dpiegdon/kicad-modules/package3d/LED_5730.step

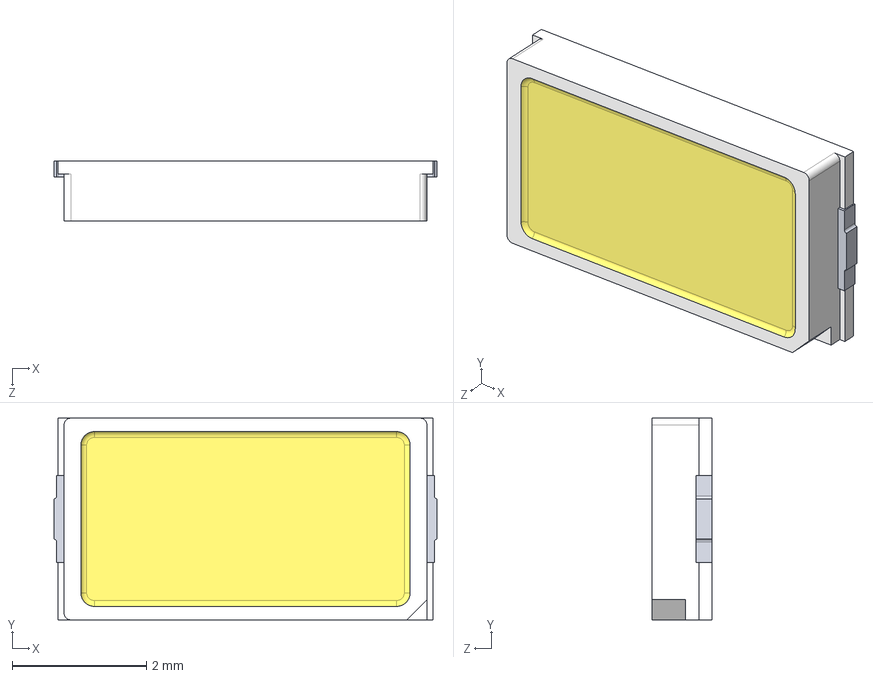
[picture p1: CAD file, 2025-06-07]
package3d/LED_5730.step
5.70 x 3.00 x 0.9 mm
