dpiegdon/kicad-modules/package3d/TS-1224W_Side_Button_2x4x3.3mm_3.5mm_3.8mm_SMD_Aliexpress.step

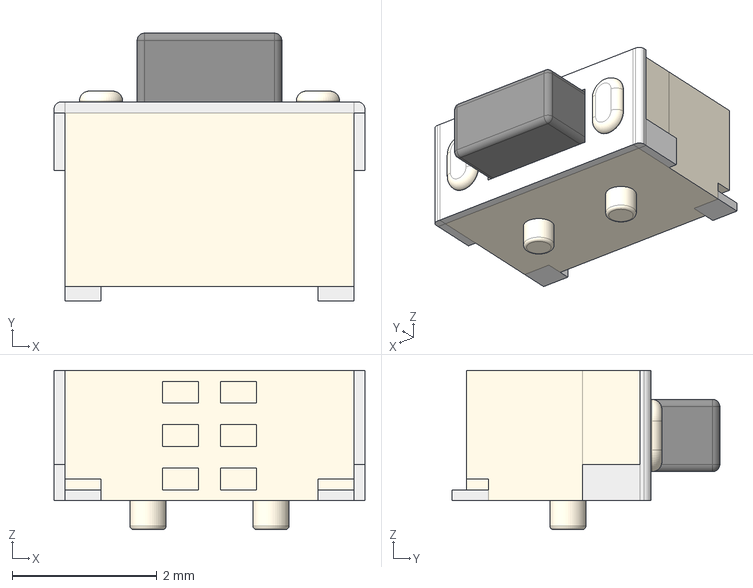
[picture p2: CAD file, 2019-12-23]
package3d/TS-1224W_Side_Button_2x4x3.3mm_3.5mm_3.8mm_SMD_Aliexpress.step
4.30 x 3.70 x 2.20 mm
