dpiegdon/kicad-modules/package3d/BatteryHolder_CR2450_BC-2005.step

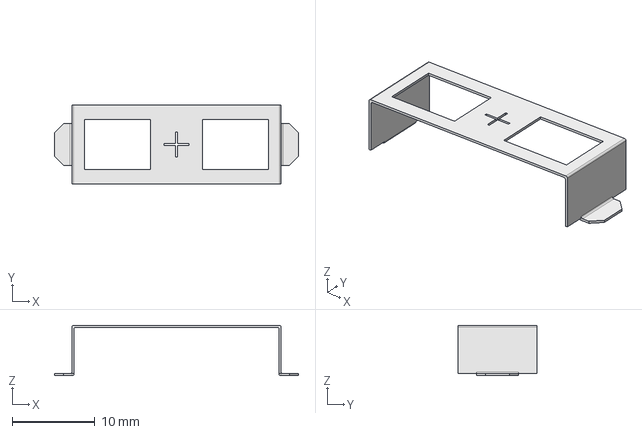
[picture p3: CAD file, 2019-12-22]
package3d/BatteryHolder_CR2450_BC-2005.step
29.5 x 9.56 x 6.09 mm
