dpiegdon/kicad-modules/(list of files, cad)

Other CAD files:
package3d/BatteryHolder_CR2450_BC-2005.FCStd
package3d/TS-1224W_Side_Button_2x4x3.3mm_3.5mm_3.8mm_SMD_Aliexpress.FCStd
