dpiegdon/kicad-modules/(commit log)

2015-08-16 on_semi n/p mosfet
2015-08-24 current, cleanup
2015-08-26 custom footprint lib
2015-08-27 solder masks, cleanup
2015-08-27 current footprints
2015-08-28 some more footprints
2015-09-02 removed unused, empty SIM footprints
2015-09-11 added IRF7509PBF-1 piece and Micro8 footprint
2015-09-14 corrected pin order for MFF2 footprint
2015-09-14 added missing GND pins to LSM303D and AT24CM02
2015-09-16 fixed DHVQFN20 (was mirrored) ; GE866 footprint cleanup for nicer schematic
2015-09-16 cleanup GSM antenna 2JE03
2015-09-16 GSM and GPS antenna cleanup
2015-09-20 cleanup STM32L051 footprint stuff
2015-09-20 SIM card slot footprint
2015-09-21 STM32L0xxKx cleanup: generalisations, footprint cleanup
2015-09-21 removed obsolete UFQFPN32 (replaced by standard QFN-32-1EP_5x5mm_Pitch0.5mm)
2015-09-21 STM32L0xxKx: difference between QFN32 and QFP32...: 2 less usable pins...
2015-09-21 removed obsolete QFN32_5x5 (use Housings_DFN_QFN:QFN-32-1EP_5x5mm_Pitch0.5mm)
2015-09-22 cleanup of all SIM footprints
2015-09-23 STM32L0*: mark VSS pin as power output
2016-03-31 fixed LTC3331 pin type to avoid DRC error when pulling balancer to GND
2016-04-10 added fiducial 0.5mm inner, 1.5mm outer radius
2017-07-03 added SMTU-2032 battery holder footprint
2018-05-12 added OnSemi NDC7001C dual p/n channel FET
2018-11-19 added footprints for E73-2G4M80S1C and cheap usb-micro port
2018-11-24 added MCML4-L SPDT switch with LED
2018-11-25 added keepout area for MCML4-L switches
2018-11-25 usb connector: changed alignment notch size to value from datasheet
2018-11-25 added descriptions on SW_Push_LED MCML4-L switch
2019-07-21 added small side button from aliexpress
2019-07-31 improved SideButton 2x4x3.3 footprint
2019-08-02 CR2032 battery holder: properly name and add courtyard
2019-08-02 added Battery Holder for CR2450
2019-08-02 improve CR2450 footprint
2019-08-09 reduce negative pad of CR2450 battery holder.
    otherwise no vias can be placed in the area.
    possible solutions: put some solder on the smaller negative pad, so
    contact is guaranteed.
2019-09-03 Footprint for pad stripe 1x08
2019-09-08 cleanup TCXO footprint, add matching stock 3d model
2019-12-22 add basic 3d model for BatteryHolder_CR2450_BC-2005
    [BatteryHolder_CR2450_BC-2005.FCStd, BatteryHolder_CR2450_BC-2005.step]
2019-12-22 improve BC-2005 model
    [BatteryHolder_CR2450_BC-2005.FCStd, BatteryHolder_CR2450_BC-2005.step]
2019-12-23 add 3d model for TS-1224W_Side_Button
    [TS-1224W_Side_Button_2x4x3.3mm_3.5mm_3.8mm_SMD_Aliexpress.FCStd, TS-1224W_Side_Button_2x4x3.3mm_3.5mm_3.8mm_SMD_Aliexpress.step]
2019-12-23 add colors to model TS-1224W_Side_Button
    [TS-1224W_Side_Button_2x4x3.3mm_3.5mm_3.8mm_SMD_Aliexpress.FCStd, TS-1224W_Side_Button_2x4x3.3mm_3.5mm_3.8mm_SMD_Aliexpress.step]
2020-04-05 add Analog Devices AD57x1
2020-04-08 fix pin assignment in AD57x1
2020-04-11 TPS652510: make second vout pin "passive" so DRC does not trip when both are bridged
2020-04-12 add some footprint assosiations
2020-04-12 add footprints for 1575R GPS antenna and OCXR 8663-XS
2020-04-12 cleanup pin assignment for TPS652510
2020-04-20 provide fixed footprint (from upstream) for ublox NEO (thanks to JLCPCB for spotting this!)
2020-04-22 side-button: reduce mechanical alignment hole to proper size
2020-05-07 change GPS Antenna 1575R such that either a ceramic antenna, or an SMA connector can be placed.
2025-06-06 port libraries epson, lattice_fpga; improve mechanical pads in TS-1224W button
    Ported libraries epson, lattice_fpga to new kicad format
    TS-1224W: design rules always complained about two adjunct pads that
    were used to implement a complex mechanical mounting pad. Pad has been
    replaced by polygon region in F.Cu et al.
2025-06-06 lattice_fpga: ICE40LP384: include center pad with no connection
    design rules complained about unconnected pad that did not exist in
    footprint.
2025-06-07 copy LED_5730 from https://github.com/kylemanna/kicad-library/blob/master/3d/LED_5730.step
    including license reference (apache 2.0) and notice on apparent author (Kyle Manna)
    [LED_5730.step]
2025-08-19 add usb-a trace-on-pcb footprint from wickerbox / usbarmory
    source: https://github.com/wickerbox/wickerlib/blob/master/libraries/Wickerlib.pretty/CONN-USB-A-PCB-TRACES.kicad_mod
2025-08-28 iCE40LP384: add GBIN numbers, add bank power sources, restructure
